RoqueMontt/KiCad-INO_Library/3D_Models/Connectors/Connector_Hirose_39P_FH23-39S-0.3SHW(05).stp

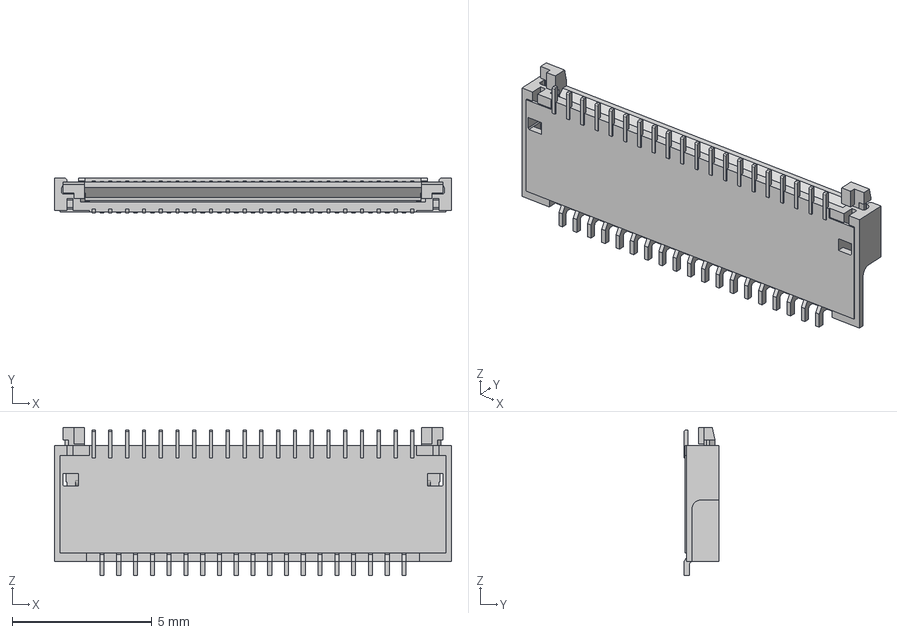
[picture p2: CAD file, 2026-01-23]
3D_Models/Connectors/Connector_Hirose_39P_FH23-39S-0.3SHW(05).stp
14.2 x 1.25 x 5.30 mm
