RoqueMontt/KiCad-INO_Library/3D_Models/ICS/IC_TPS65185RGZR.step

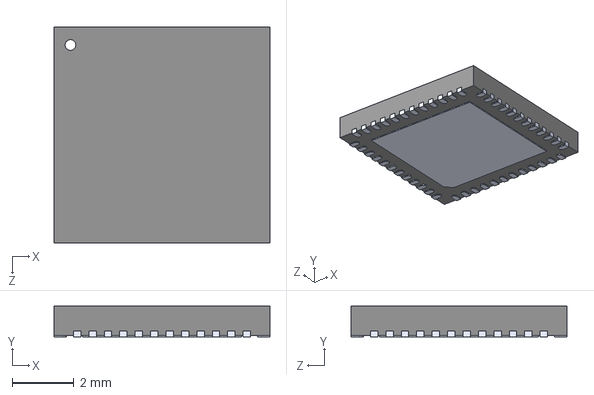
[picture p3: CAD file, 2026-01-23]
3D_Models/ICS/IC_TPS65185RGZR.step
7.00 x 1.00 x 7.00 mm
