RoqueMontt/KiCad-INO_Library/3D_Models/LED/MEIHUA_MHP1515.step

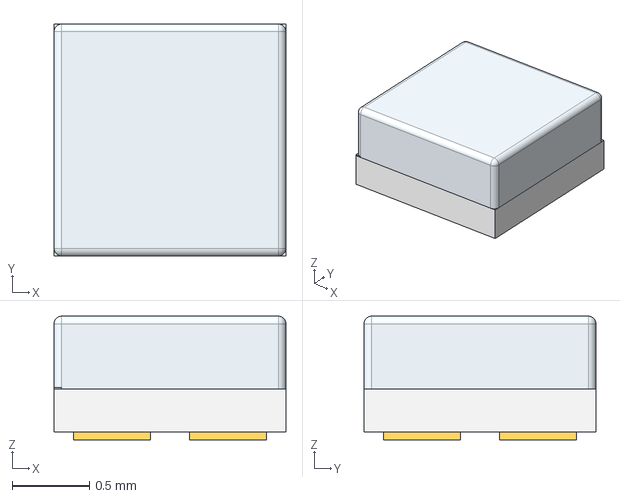
[picture p4: CAD file, 2026-01-17]
3D_Models/LED/MEIHUA_MHP1515.step
1.50 x 1.50 x 0.8 mm
