RoqueMontt/KiCad-INO_Library/3D_Models/Resistors/R_2512_6332Metric.step

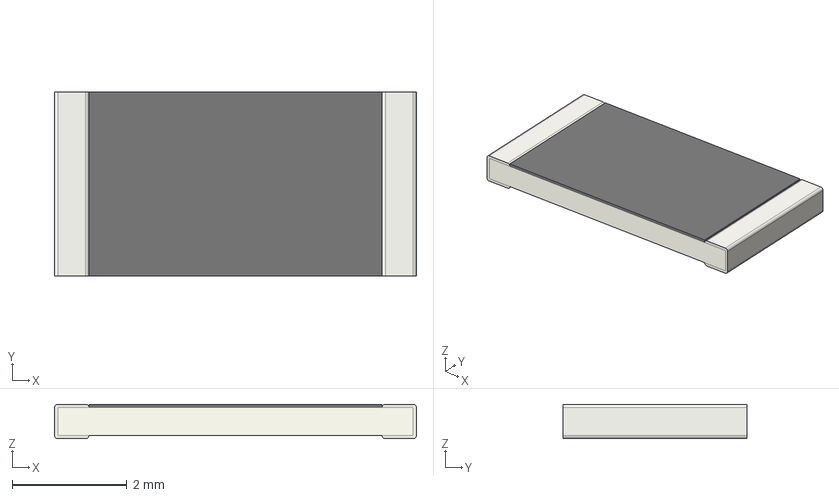
[picture p5: CAD file, 2026-01-17]
3D_Models/Resistors/R_2512_6332Metric.step
6.30 x 3.20 x 0.6 mm
