RoqueMontt/KiCad-INO_Library/3D_Models/Capacitors/C_0603_1608Metric.step

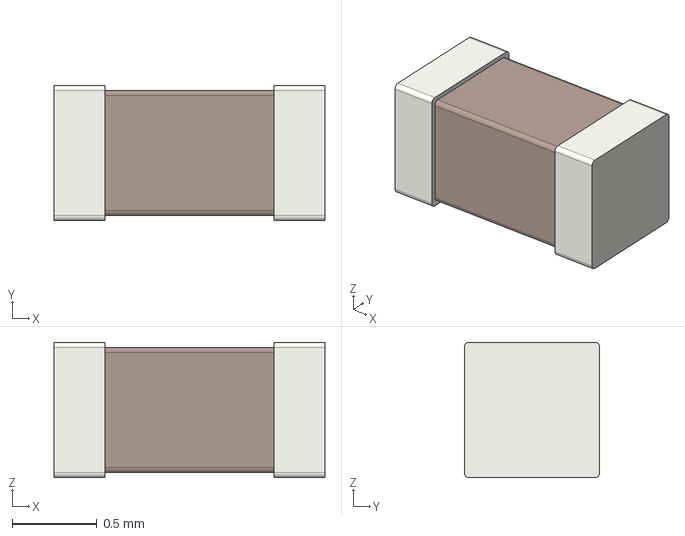
[picture p6: CAD file, 2026-01-17]
3D_Models/Capacitors/C_0603_1608Metric.step
1.60 x 0.8 x 0.8 mm
