RoqueMontt/KiCad-INO_Library/3D_Models/ICS/IC_BQ25798.step

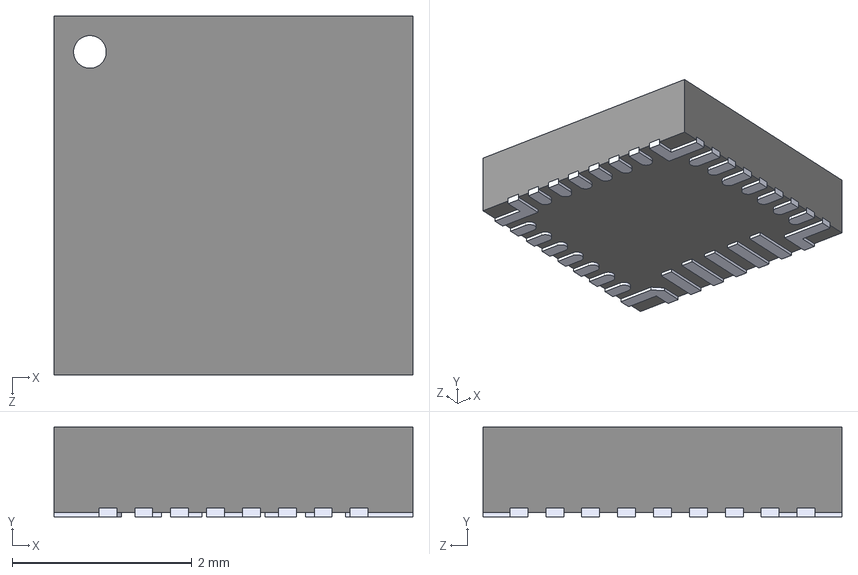
[picture p7: CAD file, 2026-01-23]
3D_Models/ICS/IC_BQ25798.step
4.00 x 1.00 x 4.00 mm
