RoqueMontt/KiCad-INO_Library/3D_Models/Resistors/R_0402_1005Metric.step

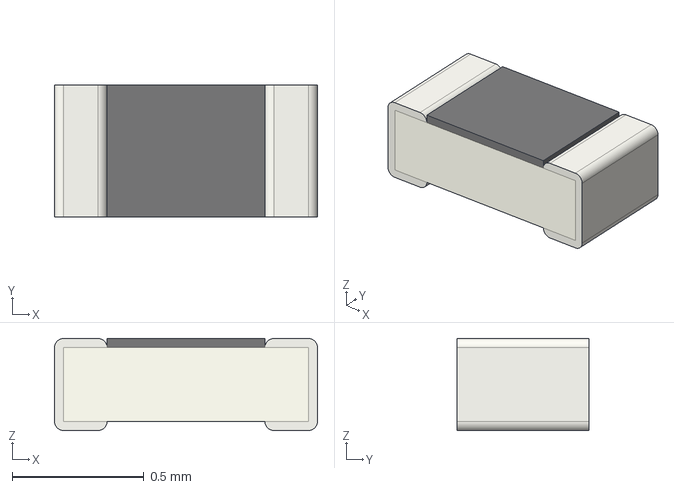
[picture p8: CAD file, 2026-01-17]
3D_Models/Resistors/R_0402_1005Metric.step
1.00 x 0.5 x 0.35 mm
