RoqueMontt/KiCad-INO_Library/3D_Models/Resistors/R_0805_2012Metric.step

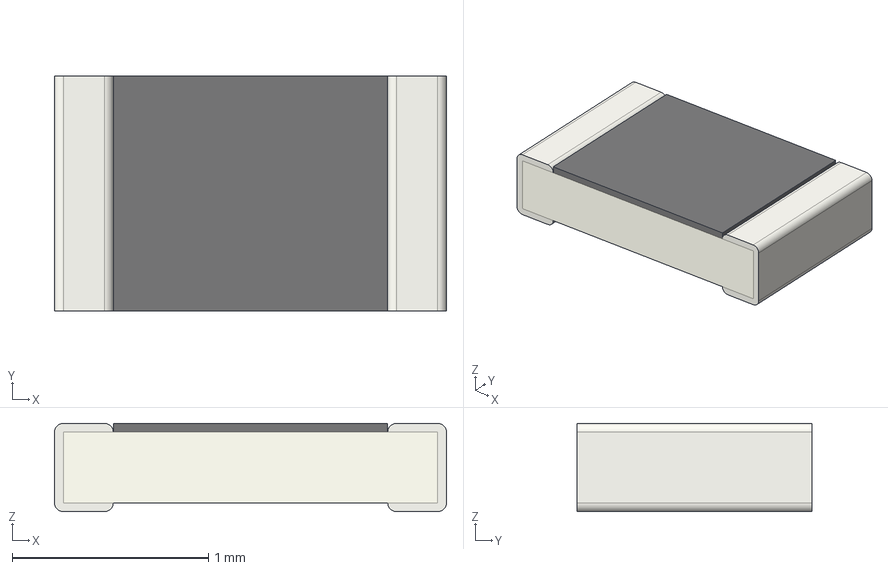
[picture p10: CAD file, 2026-01-17]
3D_Models/Resistors/R_0805_2012Metric.step
2.00 x 1.20 x 0.45 mm
