RoqueMontt/KiCad-INO_Library/3D_Models/Capacitors/CP_Elec_8x10.5.step

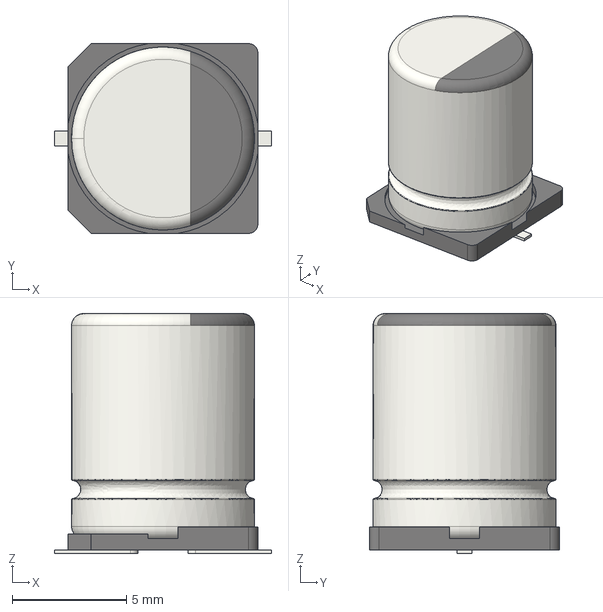
[picture p11: CAD file, 2026-01-17]
3D_Models/Capacitors/CP_Elec_8x10.5.step
9.50 x 8.30 x 10.5 mm
