RoqueMontt/KiCad-INO_Library/3D_Models/Resistors/R_1206_3216Metric.step

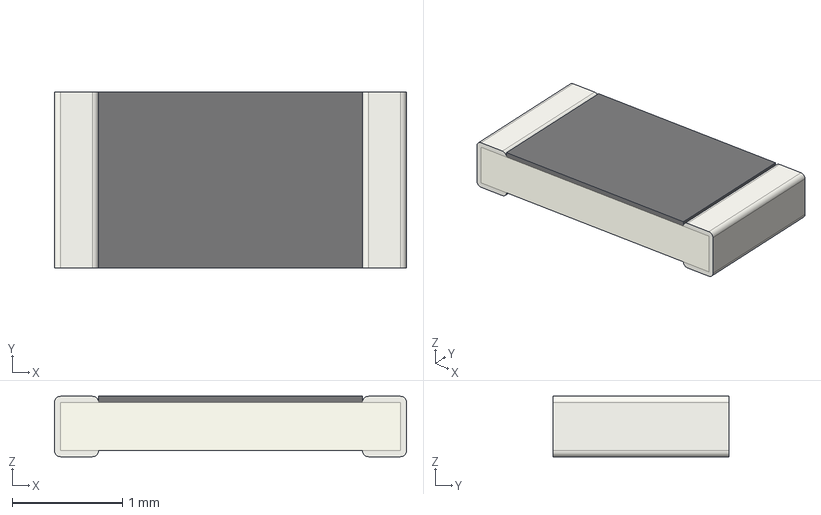
[picture p12: CAD file, 2026-01-17]
3D_Models/Resistors/R_1206_3216Metric.step
3.20 x 1.60 x 0.55 mm
