RoqueMontt/KiCad-INO_Library/3D_Models/Capacitors/C_0805_2012Metric.step

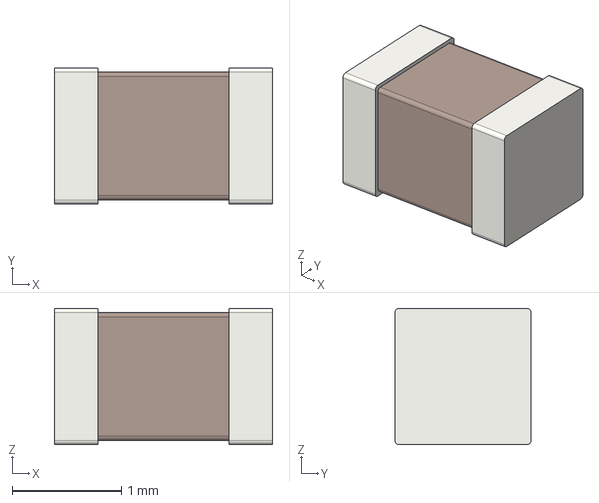
[picture p13: CAD file, 2026-01-17]
3D_Models/Capacitors/C_0805_2012Metric.step
2.00 x 1.25 x 1.25 mm
