RoqueMontt/KiCad-INO_Library/3D_Models/Resistors/R_0603_1608Metric.step

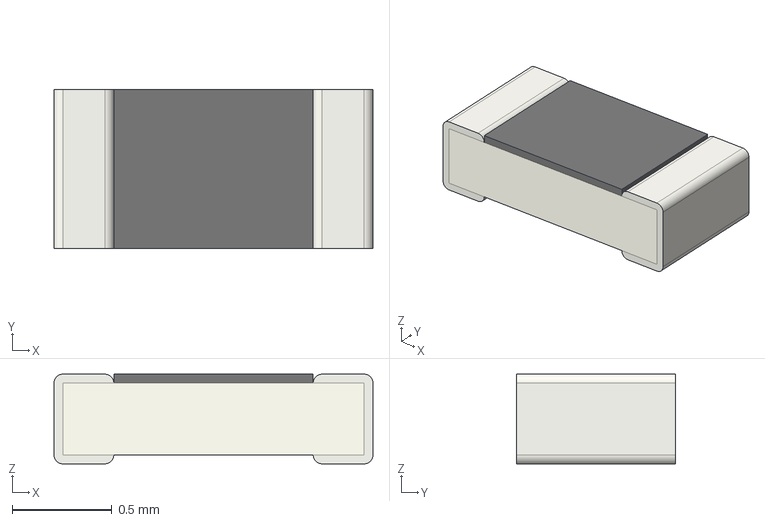
[picture p14: CAD file, 2026-01-17]
3D_Models/Resistors/R_0603_1608Metric.step
1.60 x 0.8 x 0.45 mm
