RoqueMontt/KiCad-INO_Library/3D_Models/Capacitors/CP_Elec_6.3x7.7.step

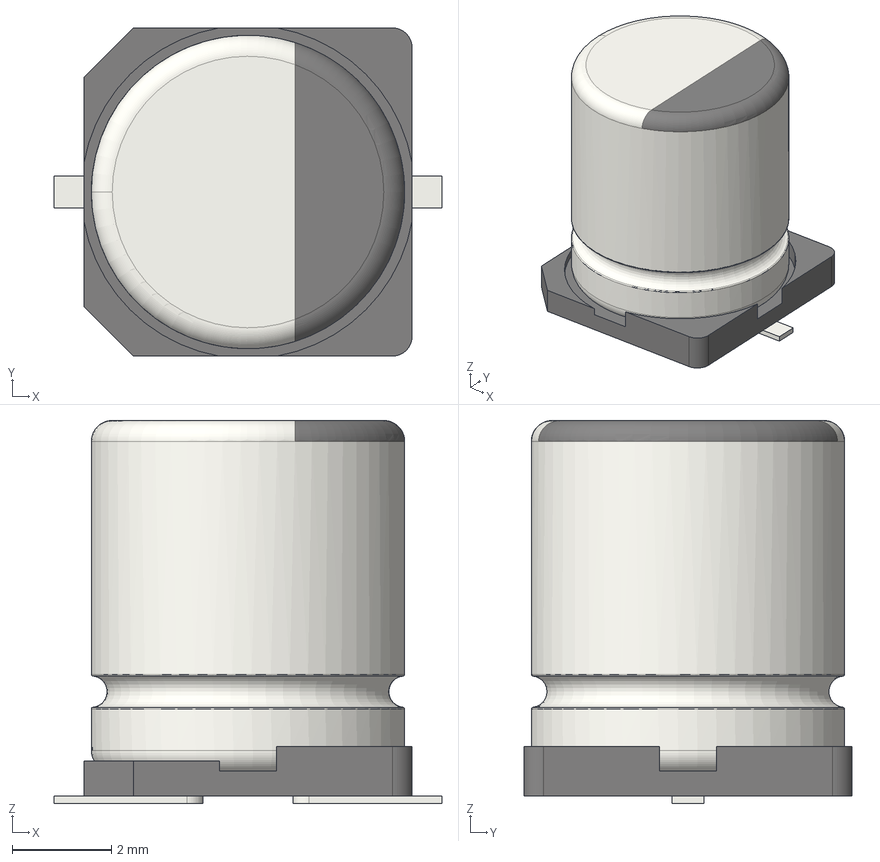
[picture p15: CAD file, 2026-01-17]
3D_Models/Capacitors/CP_Elec_6.3x7.7.step
7.80 x 6.60 x 7.70 mm
