RoqueMontt/KiCad-INO_Library/3D_Models/Resistors/R_1210_3225Metric.step

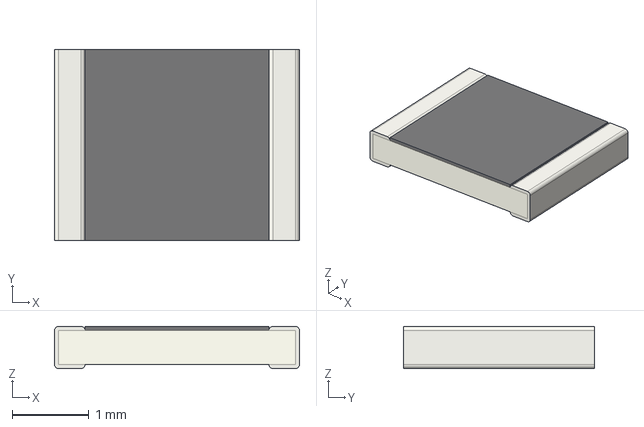
[picture p16: CAD file, 2026-01-17]
3D_Models/Resistors/R_1210_3225Metric.step
3.20 x 2.50 x 0.55 mm
