RoqueMontt/KiCad-INO_Library/3D_Models/Capacitors/CP_Elec_6.3x5.8.step

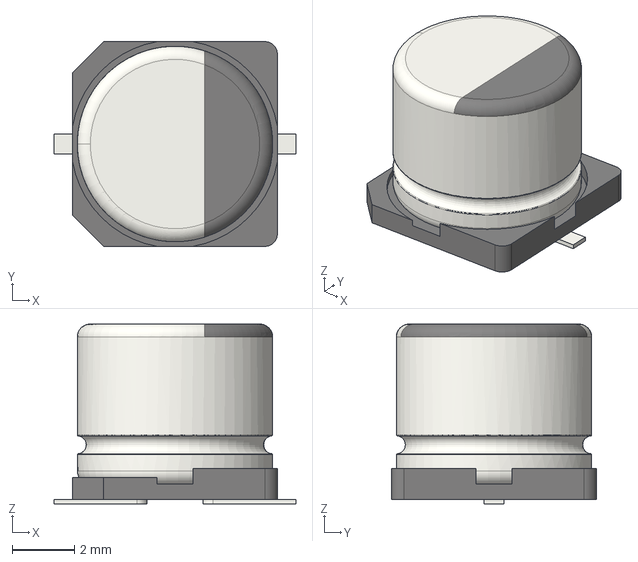
[picture p17: CAD file, 2026-01-17]
3D_Models/Capacitors/CP_Elec_6.3x5.8.step
7.80 x 6.60 x 5.80 mm
