RoqueMontt/KiCad-INO_Library/3D_Models/Capacitors/CP_Elec_5x5.7.step

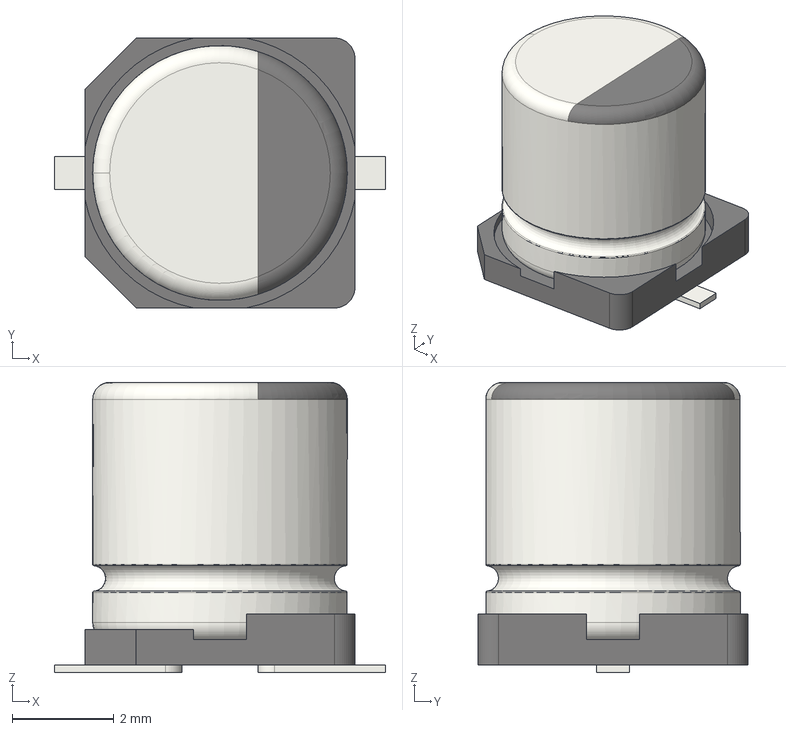
[picture p18: CAD file, 2026-01-17]
3D_Models/Capacitors/CP_Elec_5x5.7.step
6.50 x 5.30 x 5.70 mm
