RoqueMontt/KiCad-INO_Library/Project_Template/Architecture.kicad_sch

## KiCad design Project_Template/Architecture.kicad_sch (2026-01-17)

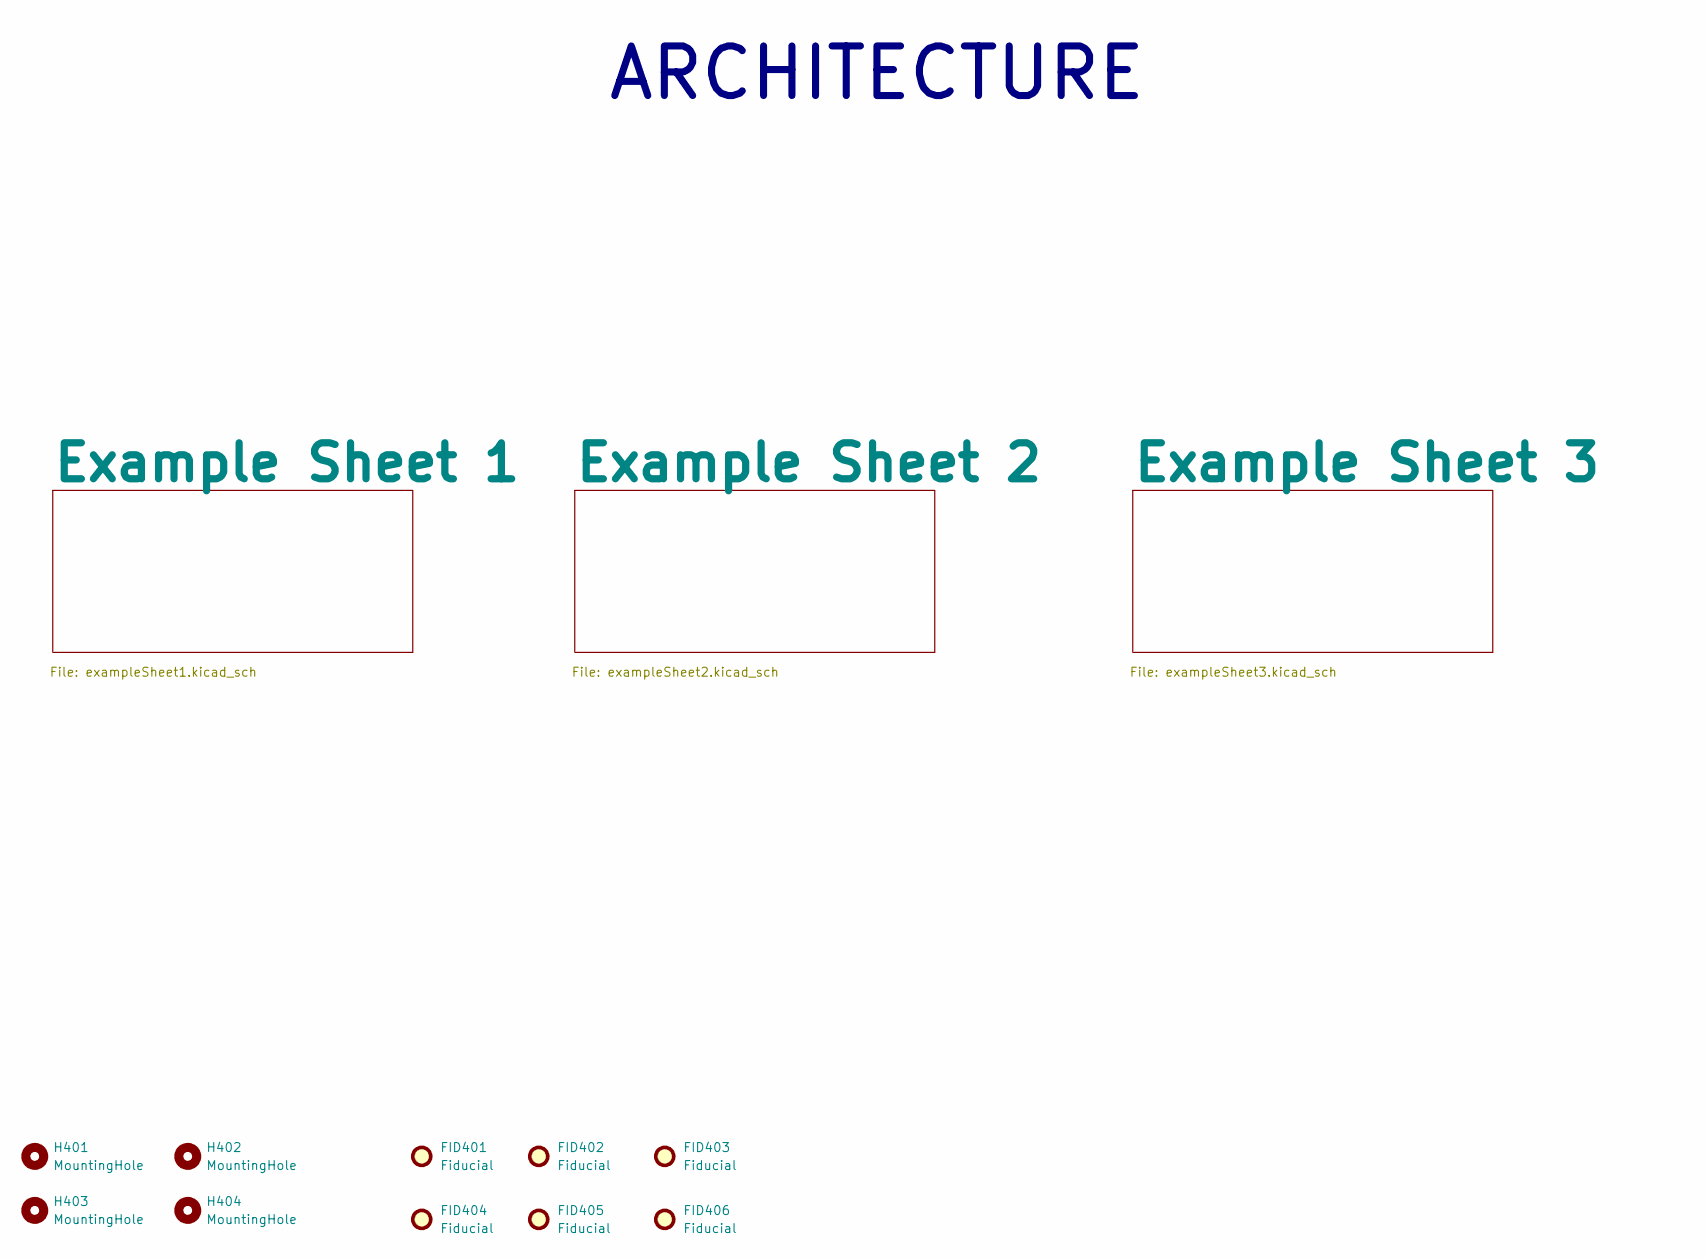
[picture p19: schematic Architecture.kicad_sch]

Parts:
FID401, FID402, FID403, FID404, FID405, FID406: Fiducial; Fiducial_0.5mm_Mask1mm
H401, H402, H403, H404: MountingHole; MountingHole_2.2mm_M2

Notes on the sheet:
ARCHITECTURE
