RoqueMontt/KiCad-INO_Library/Project_Template/Project_Template.kicad_sch

## KiCad design Project_Template/Project_Template.kicad_sch (2026-01-19, an earlier design)

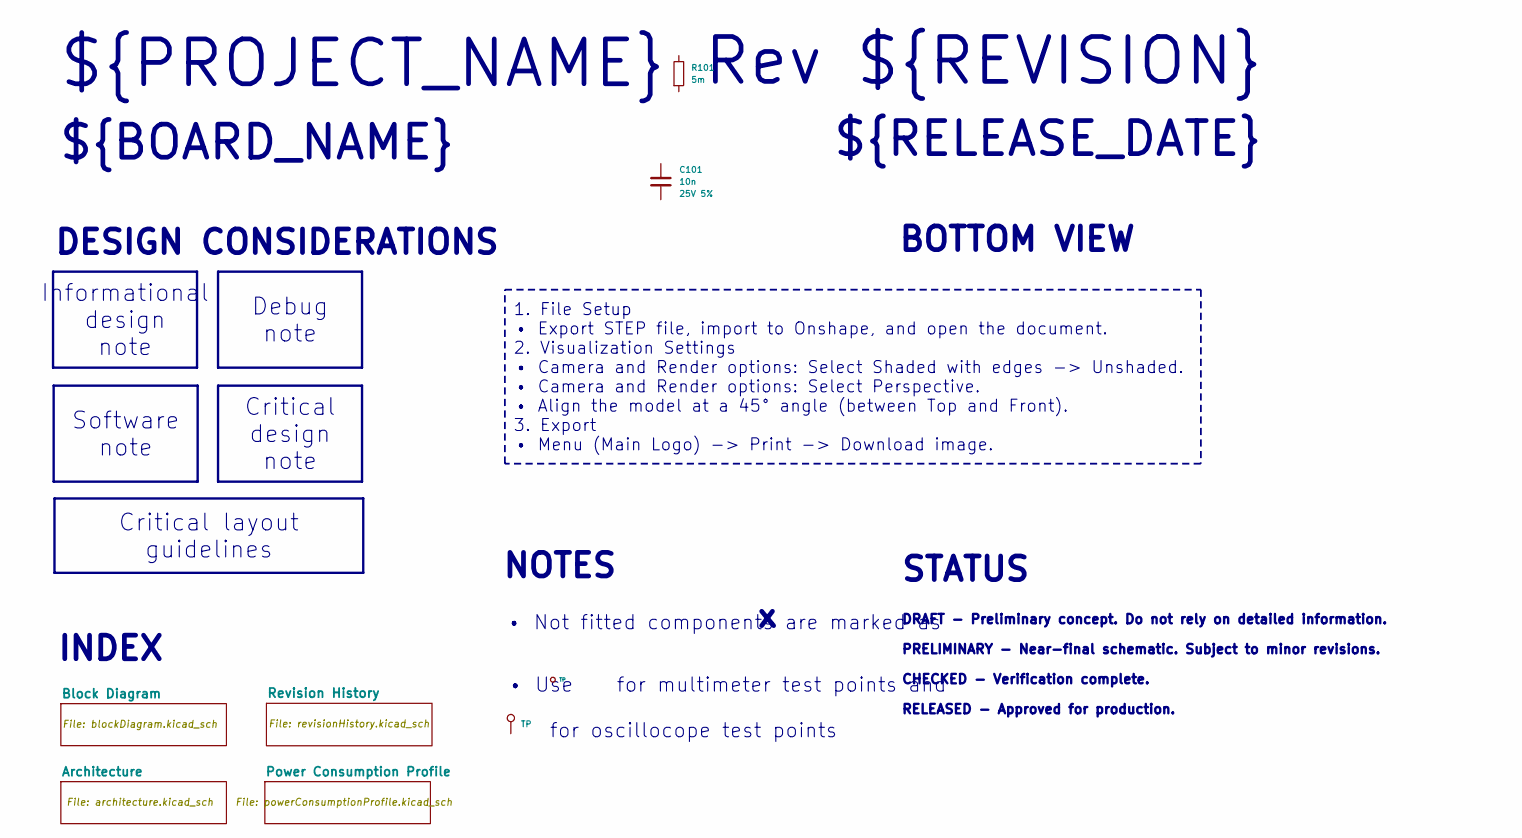
[picture p20: schematic Project_Template.kicad_sch]

Parts:
C101: 10n; C_0402_1005Metric; Rating 25V 5%; MPN GRM1555C1E103JE01D; LCSC C3855387
R101: 5m; R_2512_6332Metric; MPN HoYLR2512-2W-5mR-1%; LCSC C5375417
TP101: TP; TestPoint_Pad_D1.0mm
TP102: TP; TestPoint_Keystone_5019_Miniature; MPN RH-5019; LCSC C5199800

Notes on the sheet:
INDEX
DRAFT - Preliminary concept. Do not rely on detailed information.
${RELEASE_DATE}
PRELIMINARY - Near-final schematic. Subject to minor revisions.
STATUS
NOTES
CHECKED - Verification complete.
Rev ${REVISION}
RELEASED - Approved for production.
BOTTOM VIEW
• Not fitted components are marked as
${BOARD_NAME}
DESIGN CONSIDERATIONS
${PROJECT_NAME}
• Use for multimeter test points and for oscillocope test points
Debug note
1. File Setup • Export STEP file, import to Onshape, and open the document. 2. Visualization Settings • Camera and Render options: Select Shaded with edges -> Unshaded. • Camera and Render options: Select Perspective. • Align the model at a 45° angle (between Top and Front). 3. Export • Menu (Main 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
Critical layout guidelines
Critical design note
Software note
Informational design note
