RoqueMontt/KiCad-INO_Library/(commit log)

2026-01-17 Initial commit of KiCad DB
    [Architecture.kicad_sch, BlockDiagram.kicad_sch, CP_Elec_5x5.7.step, CP_Elec_6.3x5.8.step, CP_Elec_6.3x7.7.step, CP_Elec_8x10.5.step, C_0402_1005Metric.step, C_0603_1608Metric.step]
2026-01-17 Fix capacitors and resistors csv files
    [capacitors.csv, resistors.csv]
2026-01-17 Test: Add one component
    [capacitors.csv]
2026-01-17 Test: Add new field
    [capacitors.csv]
2026-01-17 Test: Add new table
    [osc.csv]
2026-01-19 Edit gitignore
    [PowerConsumptionProfile.kicad_sch, Project_Template.kicad_sch, exampleSheet1.kicad_sch, exampleSheet2.kicad_sch, exampleSheet3.kicad_sch, mcu.csv, reg.csv]
2026-01-23 Add E24 0402&0603 Resistors
    [Connector_Hirose_39P_FH23-39S-0.3SHW(05).stp, IC_BQ25798.step, IC_TPS65185RGZR.step, connectors.csv, dsemiconductors.csv, ics.csv, inductors.csv, leds.csv]
